openenergymonitor/build-workshop/emontx-pixel-emonesp/README.md

# Energy Monitor Build Workshop

The workshop will cover building a web-connected singe-phase AC energy monitor using the open-source Arduino, ESP8266 and Emoncms platforms.

## 1.emonTx Energy Monitor

The emonTx is based on the Arduino platform using the 8-bit ATmega328p microcontroller to take samples of the current and voltage waveforms and calculate a power reading. The power reading is then printed to the UART serial pins.  

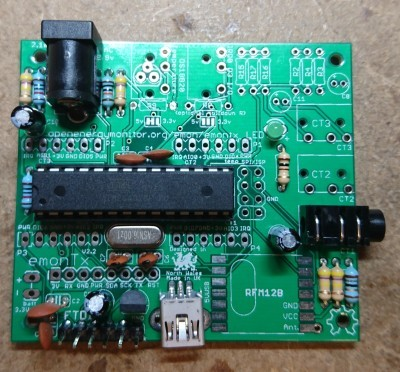
[picture p1: emontx-pixel-emonesp/emontx/images/build0010.jpg]


### a.) [Assemble emonTx](emontx) 	
### b.) [Load Firmware](emontx/firmware)

## 2. [WiFi Pixel Display](pixel/readme.md)

The WiFi Pixel display features the ESP8266 wifi-enabled microcontroller and and 16 neo-pixel serial addressable RGB LEDs. We can use it to:  

### a.) Display power value using LEDS

- Take serial UART string from emonTx e.g. `ct1:724,vrms:231`
- Display visual LED indication of power value from `ct1` sensor

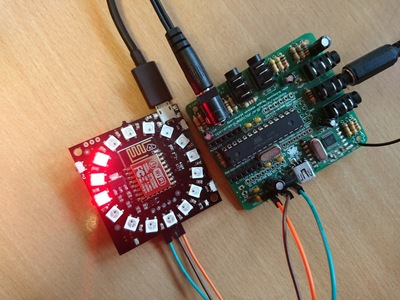
[picture p2: emontx-pixel-emonesp/pixel/images/build001.jpg]


### b.) Configure WiFi & post to Emoncms.org

- Serve up a config web-page via internal web-server
- Post to [Emoncms.org](https://emoncms.org) via WiFi

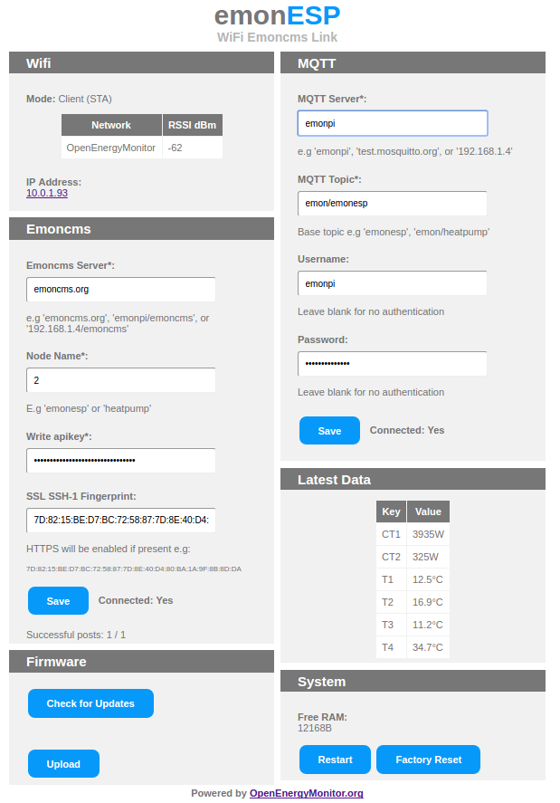
[picture p3: emontx-pixel-emonesp/pixel/firmware/EmonESP/docs/emonesp.png]


## 3. [Emoncms.org](https://emoncms.org)

Post data readings online to [Emoncms.org](https://emoncms.org) cloud  application via WiFi connection. Emoncms can be used to log, visualise and analyse power data.

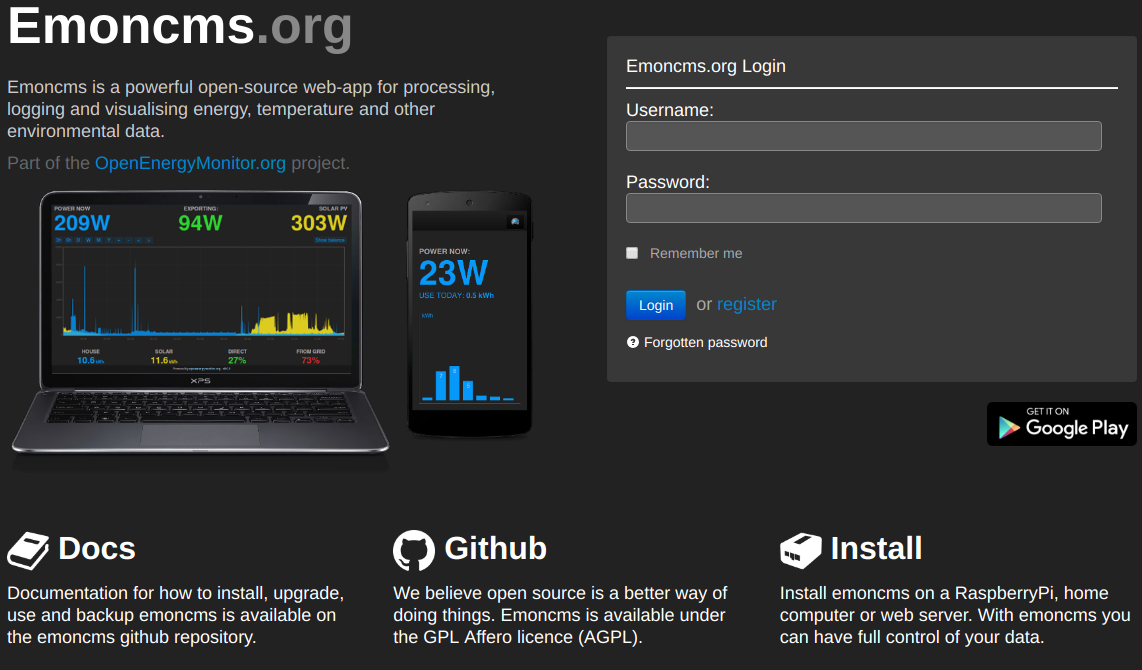
[picture p4: emontx-pixel-emonesp/pixel/images/emoncmsorg.png]


- [Example Live MyElectric dashboard](https://emoncms.org/app?readkey=c0c644bb3f86eab9e308668b5bef6b51#myelectric)
- [Example live MySolarPV Dashboard](https://emoncms.org/app?readkey=871ad5efb8f20f698f12d751aea9b8a6#mysolarpv)
- [Live custom dashboard example](http://vpn.linemanhut.co.uk:8080/emoncms/dashboard/view?id=1)

***

## Costs 

If you want to take the unit home to have a web connected energy monitor for your home / flat: 

### Energy Monitor

- 1 x emonTx
- 1 x CT Sensor
- 1 x AC-AC adapter
- 1 x Mini USB cable
- 1 x USB to UART programmer

**= 26 GBP** = 29.5 EUR (+VAT)

Payment can be made via our [web shop: order X number of ‘customized payment units’](http://shop.openenergymonitor.com/customized-order-payment-unit) where X is the cost of the kit in GBP. 

### Display & web connection 

- 1 x WiFi Pixel (ESP8266)

**= 10 GBP** = 11.36 EUR (+VAT)

***

**TOTAL = 36 GBP** = 40.10 EUR 

***

*Glyn Hudson | [OpenEnergyMonitor.org](https://openenergymonitor.org) | November 2016*
