openenergymonitor/build-workshop/emontx-pixel-emonesp/theory/files/BurdenResistorCalculator_0.xls

Sheet: Burden Resistor Calculator
Burden Resistor Calculator
 | Editable Fields
240 | V Supply
current transformer
100 | A max
50 | mA output
2000 | turns
100 | A Desired max current
70.71067812 | mA peak output
141.4213562 | A max current (p2p)
0.07071067812 | A max peak current
5 | V max micro input voltage
35.35533906 | Ω Burden Resistor
33 | closest lower standard R Value
32 | closest resistance if using 2 in series
33 | USE A SINGLE RESISTOR
0.07575757576 | A actual max peak current
151.5151515 | A actual max current (p2p)
107.1373911 | A max current (rms) before exceeding max Input Voltage
12 | bits ADC resolution
4095 | max analog value @ 107.14V
3822.194995 | analog value @ desired max currrent
4.667 | Vin @ desired max current
18.5000185 | +/- mA (load) Resolution (Error)
4.44000444 | +/- Watts error
2.616297707 | % error
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
