openenergymonitor/build-workshop/emontx-pixel-emonesp/theory/files/3-phase-power.png

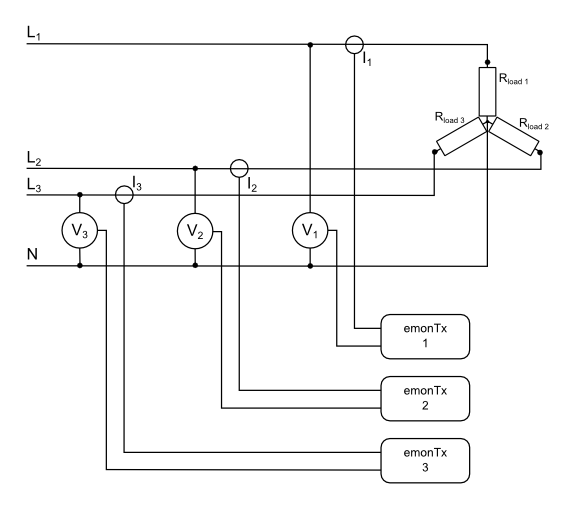
emontx-pixel-emonesp/theory/files/3-phase-power.png
