openenergymonitor/build-workshop/emontx-pixel-emonesp/theory/files/bbar_clamp.jpg

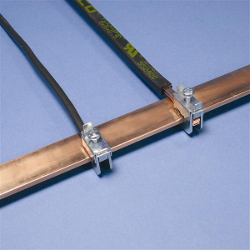
emontx-pixel-emonesp/theory/files/bbar_clamp.jpg
