openenergymonitor/build-workshop/emontx-pixel-emonesp/theory/files/CT6-inside.jpg

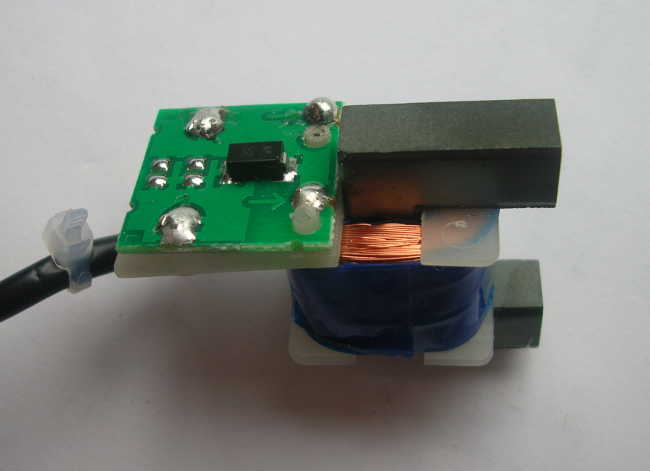
emontx-pixel-emonesp/theory/files/CT6-inside.jpg
