openenergymonitor/build-workshop/emontx-pixel-emonesp/theory/files/CT6.jpg

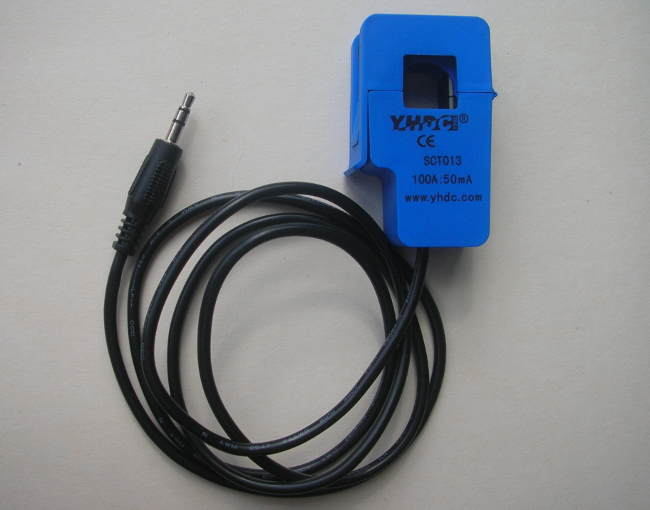
emontx-pixel-emonesp/theory/files/CT6.jpg
