openenergymonitor/build-workshop/emontx-pixel-emonesp/theory/files/current.png

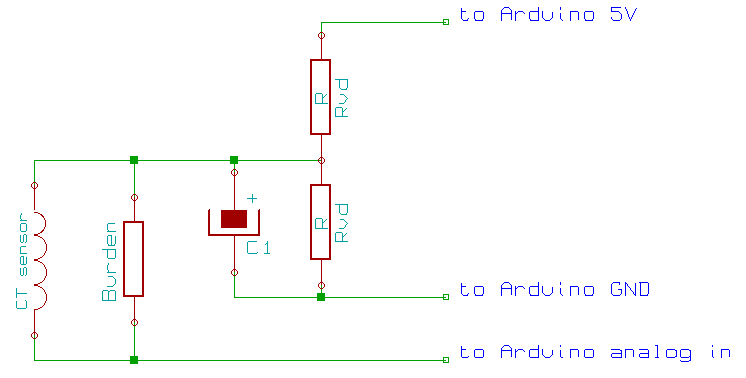
emontx-pixel-emonesp/theory/files/current.png
