openenergymonitor/build-workshop/emontx-pixel-emonesp/theory/files/currentOnly_bb.png

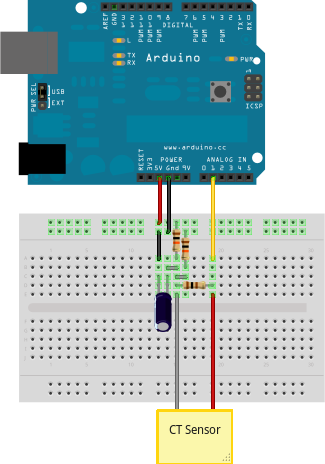
emontx-pixel-emonesp/theory/files/currentOnly_bb.png
