openenergymonitor/build-workshop/emontx-pixel-emonesp/theory/files/Fig A.png

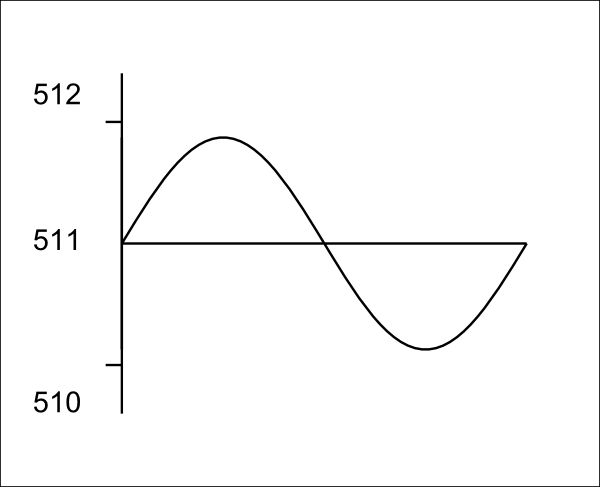
emontx-pixel-emonesp/theory/files/Fig A.png
