openenergymonitor/build-workshop/emontx-pixel-emonesp/theory/files/g_clamp.jpg

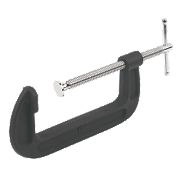
emontx-pixel-emonesp/theory/files/g_clamp.jpg
