openenergymonitor/build-workshop/emontx-pixel-emonesp/theory/files/instvi.png

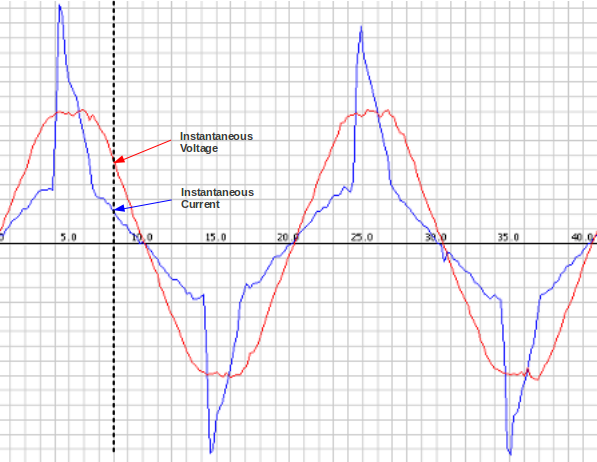
emontx-pixel-emonesp/theory/files/instvi.png
