openenergymonitor/build-workshop/emontx-pixel-emonesp/theory/files/meters-incomers.png

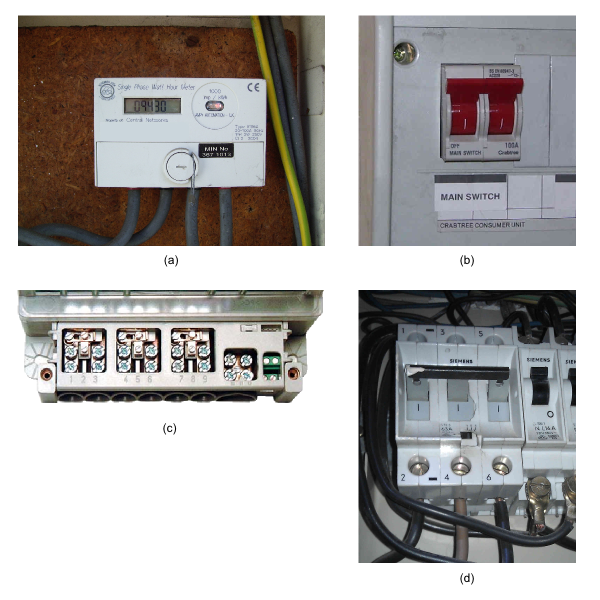
emontx-pixel-emonesp/theory/files/meters-incomers.png
