openenergymonitor/build-workshop/emontx-pixel-emonesp/theory/files/N_America_Sentran_dims.png

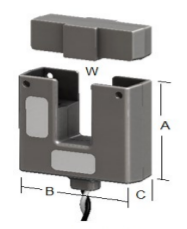
emontx-pixel-emonesp/theory/files/N_America_Sentran_dims.png
