openenergymonitor/build-workshop/emontx-pixel-emonesp/theory/files/SCT-1250_CT.jpg

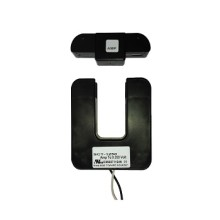
emontx-pixel-emonesp/theory/files/SCT-1250_CT.jpg
