openenergymonitor/build-workshop/emontx-pixel-emonesp/theory/files/unbalanced-load.png

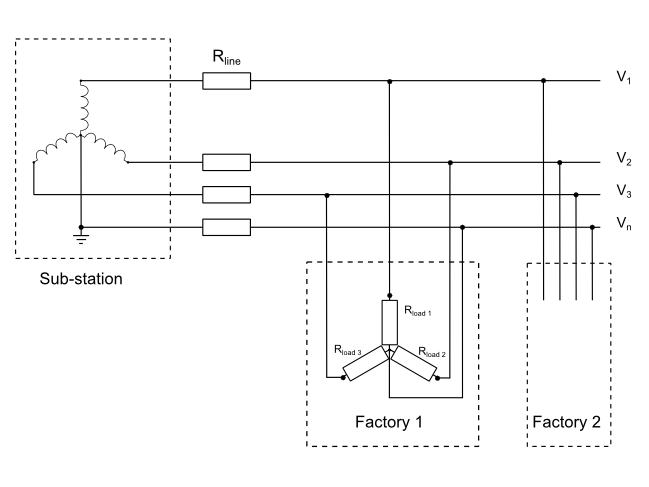
emontx-pixel-emonesp/theory/files/unbalanced-load.png
