openenergymonitor/build-workshop/emontx-pixel-emonesp/emontx/images/build005.jpg

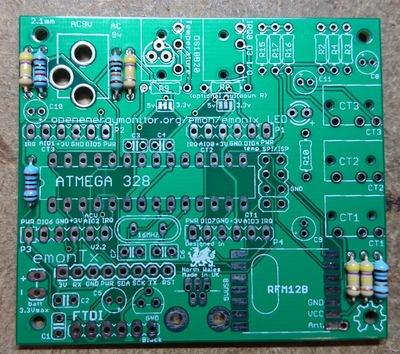
emontx-pixel-emonesp/emontx/images/build005.jpg
