openenergymonitor/build-workshop/(commit log)

2016-11-02 fist commit
    [BurdenResistorCalculator_0.xls]
2016-11-03 calibratio & tweak
2016-11-03 led delay
2016-11-03 fix wifi passkey and last data undefined
    [src.ino]
2016-11-04 display LED pixel display in any Wifi state
2016-11-06 add windows driver note
